quintinbannink42/uaefi-v1/README.md

# Ultra Affordable EFI

🟢[$175 base model rusEFI store](https://www.shop.rusefi.com/shop/p/uaefi-ultra-affordable-efi)🟢

## Community Support

🔴Community support ONLY 🔴 https://www.facebook.com/groups/rusEfi 🔴 [Discord](https://github.com/rusefi/rusefi/wiki/Discord)🔴

## SUPERSEAL 60 harness (fork)

This fork uses one TE SUPERSEAL 1.0 60-position header, **6437288-5**, on the left edge (J30 at 28.2, 138, rotation 90°, pin 1 at the south end). The dual AMPSEAL 35 headers and the 2.54 mm 2×02 sockets are removed. Ignition is logic-level smart coils only; the onboard ISL9V3040 IGBTs Q7–Q12 stay off the board. Outline is 125 × 100 mm (x 25–150, y 60–160). The old socket pin-name legend is gone; J30 keeps a silkscreen “1” on pin 1. See [docs/superseal-60-pinout.md](docs/superseal-60-pinout.md) and [docs/superseal-60-order.md](docs/superseal-60-order.md).

## Technical Details

Open Source KiCAD 7 hardware powered by [Hellen-One](https://github.com/andreika-git/hellen-one)

powerted by [rusEFI firmware](https://github.com/rusefi/rusefi)

[User Documentation](https://github.com/rusefi/rusefi/wiki/uaEFI)

x

x

## MCU options

1mg of flash is _required_.

One day we shall try https://jlcpcb.com/partdetail/Stmicroelectronics-STM32F427VIT6%2FC57097#EC or https://jlcpcb.com/partdetail/Stmicroelectronics-STM32F437VIT7%2FC1338578#EC

## rusEFI Store

https://www.shop.rusefi.com/shop/p/uaefi-ultra-affordable-efi

## HOWTO JLCPCB

You would need three files from ``boards/uaefi-a/board`` folder to place your JLCPB Assembly order: gerber.zip BOM-JLC.csv and CPL.csv

### Q: Something wrong with BOM?

A: Nope, that's normal nothing to worry about click 'Continue'.



### Q: how do I get more RAM for Lua?

A: fabricate with STM32F42xVI firmware would defect extra RAM and give you extra Lua. Once your script does not fit into STM32F42xVI it's F7 time or help us leverage F413.

### Q: I've place an order with JLCPCB and I see scary looking wrong orientation?

A: that's expected. See [boards/uaefi-c/board](boards/uaefi-c/board) ``Original*.png`` files and ``Produce*.png`` after JLCPCB manual review process.
