quintinbannink42/uaefi-v1/docs/ampseal-35-unrouted.md

# Superseded

The dual AMPSEAL headers are gone. Open J30 pads on the Superseal board are listed in [superseal-60-pinout.md](superseal-60-pinout.md).
