quintinbannink42/uaefi-v1/docs/ampseal-35-bom.csv

Note | This BOM is superseded. See docs/superseal-60-bom.csv
Qty | Value | Refs
0 | 776163-1 | removed — was J30 J31
