quintinbannink42/uaefi-v1/docs/superseal-60-bom.csv

Qty | Value | Refs | Note
1 | 6437288-5 | J30 | TE SUPERSEAL 1.0 60-pos right-angle header. Replaces two 776163-1 AMPSEAL headers.
0 | 776163-1 |  | Removed. Do not buy.
0 | PinSocket_2x02_2.54mm | J1 J11 J12 J13 J14 J15 J16 J17 J18 J19 J20 J21 J22 J24 | Removed 2.54 mm 4-pin sockets. Mezzanine modules M1-M7 stay.
1 | 4-1437290-0 |  | Mating plug | 34 position | pins 1-34. Confirm keying.
1 | 3-1437290-7 |  | Mating plug | 26 position | pins 35-60. Confirm keying.
