quintinbannink42/uaefi-v1/changelog.md

# J30 turned onto the north edge

* Rotation 180° at (128.25, 62). The shroud that used to point into the board now points off the north edge (y = 44.8). Cavity numbers are unchanged.
* Outline is **101.0 × 115.2 mm** (x 49–150, y 44.8–160). The left strip is gone.
* Proto grids `G3`, `G4`, `P1`, `P2`, `P5`, and `P6` are removed. See [docs/superseal-60-order.md](docs/superseal-60-order.md).
* New header routes use 0.55 / 0.30 mm vias. No 0.20 mm drills. Pin 7 `+5VP` is still open.

# Header pulled onto the race core

* J30 stays TE **6437288-5**, rotation 90°, pin 1 at the south end. Origin moves from (3.5, 138) to **(28.2, 138)**. Cavity numbers are unchanged. The mating shell hangs off x = 25.
* Outline shrinks from 151.2 × 112.1 mm to **125 × 100 mm** (x 25–150, y 60–160). That is the original 100 × 100 mm core plus the on-board part of the header.
* The stale socket pin-name silkscreen is removed. J30 keeps the footprint silkscreen “1”.
* The harness escape was redrawn. Shorts go from 46 to 0. Six signal pads (`IN_HALL1`–`IN_HALL3`, `VR_MAX9924+`, `EGT−`, `WBO_Un`) are still open. The five north pins can only cross the header on two stagger rows, and the via that fits there is a 0.20 mm drill, under the board's 0.30 mm minimum hole. `WBO_Un` is closed by the F.Cu `GNDA` bar; moving that bar lets the GND pour onto outer ignition copper. `OUT_IGN3`'s long thin run is now 0.40 mm. One `OUT_IGN5` run is 0.35 mm; the 26 mm run stays 0.15 mm. Power necks after the pin field stay 0.40 mm. See [docs/superseal-60-order.md](docs/superseal-60-order.md).

# SUPERSEAL 60 on the left edge

* J30 (TE **6437288-5**) moves from the right edge to the left edge: origin (3.5, 138), rotation 90°, pin 1 at the south end of the front row. Cavity numbers are unchanged. The mating shell hangs off x = 0.
* Outline is **151.2 × 112.1 mm** (x 0–151.2, y 52.4–164.5). Rev E was 100 × 100 mm. The right-edge SuperSeal board was 258 × 182 mm. The right-side growth is gone. The board is still wider and taller than 100 mm plus the 24.6 mm header courtyard, because the header escape and the top/bottom lanes sit outside the packed race core.
* No AMPSEAL, no dumb-coil IGBTs, no 2.54 mm 2×02 sockets. No pins were re-paralleled.

# SUPERSEAL 60 harness (this fork)

* One TE **6437288-5** SUPERSEAL 1.0 60-position right-angle header (J30) replaces the two AMPSEAL 35 headers and the 2.54 mm 2×02 sockets J1 and J11–J22, J24.
* Pinout, current limits, and placement: [docs/superseal-60-pinout.md](docs/superseal-60-pinout.md), [docs/superseal-60-order.md](docs/superseal-60-order.md), [docs/superseal-60-mechanical.md](docs/superseal-60-mechanical.md).
* Smart-coil only; Q7–Q12 stay removed.
* Paralleled `GND`, `+5VP`, and `GNDA` pins were reduced to fit 60 positions. No unique signal was dropped. Every J30 signal pad is routed. Continuous ratings follow the copper actually laid down (about 4.5 A on `+12V`, about 2–3 A on the 1.0–1.2 mm injector and low-side runs). A few channels stay near 1 A where the series section is still 0.30–0.55 mm. See the order doc.
* The AMPSEAL footprint and notes are superseded.

# Dual AMPSEAL harness (superseded)

* External Mini-Fit harness connectors J2, J3, J4, J5, and J10 are replaced by two TE AMPSEAL 35-pin headers J30 (outputs / power / WBO) and J31 (sensors / CAN).
* Pinout: [docs/ampseal-35-pinout.md](docs/ampseal-35-pinout.md).
* Footprint `kicad6-libraries/TE_AMPSEAL_35_776163-1.kicad_mod` is a hypothesis adapted from a public KiCad proposal; verify against TE drawing 776163 before fabrication.
* Board copper is not re-routed. One paralleled `+5VP` and one paralleled `GNDA` pin were dropped to fit 70 positions.
* Outline is a 100 × 136 mm rounded rectangle. J30 is on the bottom edge and J31 is on the top edge. See [docs/ampseal-35-mechanical.md](docs/ampseal-35-mechanical.md).
* Dumb-coil IGBTs Q7–Q12 are removed. Ignition is smart-coil only.
* Header pads are tracked to existing nets. Order notes: [docs/ampseal-35-order.md](docs/ampseal-35-order.md). Refill zones and run DRC in KiCad 8 before fabrication.

# rev E

* power supply fix for RTC
* https://github.com/rusefi/uaefi/issues?q=state%3Aopen%20label%3A%22rev-E%22

# rev D

August 2024

* logic analyzer hookup points for both VRs #66
* minor silkscreen improvements https://github.com/rusefi/uaefi/issues?q=label%3Arev-D+is%3Aclosed

# rev C

Apr 2024

* pad for resistor between VR lines
* a few silkscreen corrections
* full list https://github.com/rusefi/uaefi/issues?q=label%3Arev-C+is%3Aclosed

# rev B

Feb 2024

* [over-current protection on all low side outputs](https://github.com/rusefi/uaefi/issues/44)
* [over-current protection on ignition outputs](https://github.com/rusefi/uaefi/issues/42)
* 0805 button input pull-up/pull-downs added
* button inputs changed from 10K PU to 680K PD https://github.com/rusefi/uaefi/issues/36
* minor cosmetic https://github.com/rusefi/uaefi/labels/rev-B

# rev A

Dec 2023

It works it's great!
