quintinbannink42/uaefi-v1/(commit log)

2026-09-21 Replace Mini-Fit harness connectors with two AMPSEAL 35 headers.
    Map rev E loom nets onto J30 and J31, document the pinout, and place unverified 776163-1 footprints without re-routing.
    [uaefi.kicad_pcb, uaefi.kicad_sch]
2026-09-22 Fit both AMPSEAL headers on edge tabs and drop dead Mini-Fit tracks.
    Add a bottom tab for J30 and a right tab for J31, hang the right-angle bodies off the outline, and remove segments that ended on the old harness pads.
    [uaefi.kicad_pcb]
2026-09-24 Seat the AMPSEAL headers on opposite edges of a taller rectangle.
    Drop the right-side tab, keep J30 on the bottom, and move J31 to the top so the outline stays a rounded Hellen-One-style carrier.
    [uaefi.kicad_pcb]
2026-09-24 Remove dumb-coil IGBTs and route the AMPSEAL header pins.
    Drop Q7-Q12 from the ignition sheet and the board, track every J30/J31 signal pad to existing copper, and document the remaining KiCad 8 fab steps.
    [IGN6.kicad_sch, ampseal-35-bom.csv, uaefi.kicad_pcb]
2026-09-24 Refill zones, route AMPSEAL pads without shorts, and export KiCad 8 fab files.
    [uaefi-B_Cu.gbr, uaefi-B_Mask.gbr, uaefi-B_Paste.gbr, uaefi-B_Silkscreen.gbr, uaefi-Edge_Cuts.gbr, uaefi-F_Cu.gbr, uaefi-F_Mask.gbr, uaefi-F_Paste.gbr]
2026-09-24 Widen the board and route harness nets through a right-edge channel.
    [uaefi-B_Cu.gbr, uaefi-B_Mask.gbr, uaefi-B_Paste.gbr, uaefi-B_Silkscreen.gbr, uaefi-Edge_Cuts.gbr, uaefi-F_Cu.gbr, uaefi-F_Mask.gbr, uaefi-F_Paste.gbr]
2026-09-24 Close the remaining AMPSEAL ratsnest breaks.
    Each required J30/J31 signal net is one island from the header to the existing onboard copper. Zones were refilled, fab plots refreshed, and the order note now treats the harness as electrically complete.
    [uaefi-B_Cu.gbr, uaefi-B_Mask.gbr, uaefi-B_Paste.gbr, uaefi-B_Silkscreen.gbr, uaefi-Edge_Cuts.gbr, uaefi-F_Cu.gbr, uaefi-F_Mask.gbr, uaefi-F_Paste.gbr]
2026-09-24 AMPSEAL 35 harness: electrically complete J30/J31 nets (#1)
    * Replace Mini-Fit harness connectors with two AMPSEAL 35 headers.
    * Fit both AMPSEAL headers on edge tabs and drop dead Mini-Fit tracks.
    * Seat the AMPSEAL headers on opposite edges of a taller rectangle.
    Drop the right-side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
    [IGN6.kicad_sch, ampseal-35-bom.csv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]
2026-09-25 Replace dual AMPSEAL with one SUPERSEAL 60 (#2)
    * Replace dual AMPSEAL headers with one SUPERSEAL 60.
    J30 is a TE 6437288-5 on the grown right edge. The AMPSEAL headers and the 2.54 mm 2x02 sockets are removed. Harness tracks are sized for the 1 oz neck, not the 15 A catalog figure. Twenty-one header pads are still unconnected.
    * Route every SUPERSEAL 60 pin and widen the high-current copper.
    The header moves to (214, 78) and the outline grows to 258 by 182 mm so the power and injector runs can leave the pin field. Series widths are documented from the copper on the board, not from the Superseal catalog rating.
    Co-autho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
    [ampseal-35-bom.csv, superseal-60-bom.csv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]
2026-09-26 Move J30 SuperSeal to left edge and shrink outline (#3)
    Place the TE 6437288-5 header at (3.5, 138) rotation 90 so the mating shell hangs off the left edge, and pull Edge.Cuts in to 151.2 x 112.1 mm. The 258 x 182 mm right-edge growth is gone. Cavity numbers are unchanged. Harness necks and DRC are recorded in the SuperSeal docs.
    [uaefi-B_Cu.gbl, uaefi-B_Cu.gbr, uaefi-B_Mask.gbr, uaefi-B_Paste.gbr, uaefi-B_Silkscreen.gbr, uaefi-Edge_Cuts.gbr, uaefi-Edge_Cuts.gm1, uaefi-F_Cu.gbr]
2026-10-14 Pull J30 onto the race core and shrink the outline to 125x100.
    Move the SuperSeal header from (3.5, 138) to (28.2, 138), drop the stale socket pin legend, and redraw the harness escape so it no longer shorts module ground fingers. Six signal pads remain open where the pin field has no second gap.
2026-10-27 Widen OUT_IGN3 to class width and record the six open J30 pads.
    OUT_IGN3's 3.2 mm In1 run is now 0.40 mm, and one OUT_IGN5 front-copper run is 0.35 mm. The other OUT_IGN4/5 necks and the post-field power runs have no clearance left to grow. The six open header pads stay open: the north pins need a 0.20 mm drill in the only stagger gap, under the 0.30 mm hole minimum, and moving the GNDA bar that seals WBO_Un lets the GND pour onto ignition copper.
2026-10-29 Turn J30 to the north edge and remove the proto grids.
    The mating body was pointing into the board. Rotation 180 puts that face off the north edge, with the pin field on the board and the shroud opening past y=44.8. The left edge comes back to x=49. Outline is 101.0 x 115.2 mm. PROTO_AREA G3/G4 and test holes P1, P2, P5, and P6 are removed.
2026-10-29 Route J30 from the north edge with standard 0.55/0.30 vias.
    The mating shroud now points off the board. Proto grids G3, G4, P1, P2, P5, and P6 are gone. Header nets are redrawn at 0.20 mm with 0.55/0.30 vias. Pin 7 +5VP is still open; no 0.20 mm drill was added.
2026-10-30 Stage A: remove dead copper, reconnect broken nets, refill zones.
    The outline stays 101.0 x 115.2 mm. The width is already the original
    race-core 100 mm (+1 mm of copper at x 49.2), and the west side is
    routed copper, so moving parts would mean a full re-layout.
    Removed 206 pad-less track/via islands (incl. the /12V_KEY via behind
    the two mask bridges). Reconnected OUT_IGN1, OUT_LS1-4, +12V_RAW (J30.2,
    D2-D5), VR_MAX9924, LS_HOT1/2, +3.3VA and +5VA with 0.55/0.30 vias.
    Zone refill drops clearance errors from 171 to 11.
2026-10-30 Stage B: route J30 pin 7 (+5VP) with standard 0.55/0.30 vias.
    Pin 7 leaves on a 0.20 mm neck between the pin rows, then 0.30 mm
    to R1. The +5VP island at R1 is joined to the supply at M1.V4 with
    0.40 mm track. No 0.20 mm drill was needed, so none was added and the
    0.30 mm minimum drill holds for every via.
2026-10-30 Stage C: widen J30 power, HC, LS and IGN nets where they fit.
    Every segment of +12V, +12V_RAW, 12V_KEY, OUT_INJ1-6, OUT_DC1/2,
    OUT_LS_HOT1/2, WBO_Heater, OUT_LS1-4 and OUT_IGN1-6 was widened toward
    its class width (PWR 2.4, HC 1.2, LS 1.0, IGN 0.4) in 0.05 mm steps,
    to the widest value that keeps 0.15 mm (0.40 mm for IGN on outer
    layers) to every other net, pad, hole and the edge. No rerouting.
    DRC: 0 shorts, clearance count unchanged at 11.
2026-10-30 Replot fab/ and update the SUPERSEAL 60 docs for stages A-C.
    Gerbers, PTH/NPTH drill files and maps regenerated with kicad-cli 8.0.9 (pos.csv unchanged: no parts moved). No 0.20 mm drill on the board.
